Rajasekhar-Ilaparti/Seed-Dispensing-Rover-ESP32-C3/(commit log)

2026-11-05 Seed Dispensing Rover: ESP32-C3 firmware, wiring and docs
    Wi-Fi controlled seed-sowing rover on an ESP32-C3 Super Mini with a
    DRV8833 driver, MPU6050 gyro and servo seed hopper. The rover hosts its
    own controller page (joystick, dispense once/continuous, servo, square
    path and gyro calibration, diagnostics) and supports OTA updates.
2026-11-06 Drive tab dispense options follow saved Dispenser settings
    The Drive tab loaded swing speed and cycles from values remembered on
    the phone, so settings saved on the Dispenser tab were ignored. They now
    come from the rover's saved servo settings, update as soon as Save is
    pressed, and a running continuous dispense picks them up. The interval
    is still remembered on the phone.
2026-11-06 Lock hopper servo angles; Dispenser tab tunes timing only
    The open/closed angles are now constants in the firmware (135/75) and
    can't be changed from the controller: the live-angle control and
    /servo/set are removed, and /servo/save and /servo/test only accept
    swing speed, hold time and swings. The Dispenser tab shows the locked
    angles read-only with a caution box, and Save asks for confirmation.
2026-11-09 Fix weak low-speed driving: kick-start and full-range speed slider
    At low speed settings the joystick drove both sides at PWM 70, which
    spins the wheels in the air but barely moves a 4-wheel skid-steer rover
    on the ground, and the bottom of the speed slider all mapped to that
    same value. Each side now gets a 150 ms kick at PWM 150 when it starts
    from standstill, the minimum drive PWM is 90, and the slider spans
    PWM 90 (20 %) to 200 (100 %).
    [C3_Seed_Rover.ino]
2026-11-09 Adjustable drive power: minimum PWM and start kick
    PWM 90 was still too weak on the floor at low speed. The minimum drive
    power and the start kick are now settings on the Calibration tab
    (defaults 110 / 170), applied immediately and saved in NVS, so they can
    be tuned to the surface without a firmware upload. Also stops field
    labels from overflowing narrow phone screens.
    [C3_Seed_Rover.ino]
2026-11-09 Soft-start the motors instead of a start kick
    A sudden PWM step into stalled motors (the jump to minimum power plus
    the start kick) tripped the DRV8833 over-current protection, so the
    motors hummed on the ground while the slow ramp in the motor diagnostic
    started them fine. A side leaving standstill now begins at PWM 60 and
    speeds up at 300 PWM/s; stopping and reversing are unchanged. The start
    kick setting is removed (and its saved value erased); minimum drive
    power stays adjustable.
    [C3_Seed_Rover.ino]
2026-11-09 Switch to the TC1508A motor driver
    - Map motor sides for the TC1508A wiring (SIDES_SWAPPED, RIGHT_REVERSED,
    JOY_SWAP_LR) and document the flags for the original DRV8833 wiring
    - Fix drive power in firmware at PWM 50-100 (keeps the TC1508A cool),
    soft start from PWM 40; remove the Drive power calibration card
    - Clear old drive-power settings from NVS on boot
    - Update wiring, README, calibration and troubleshooting docs, including
    the TC1508A's 7.2 V rating against a 2S pack
    [C3_Seed_Rover.ino]
2026-11-09 Reverse the left motors in software after re-soldering
    Adds LEFT_REVERSED (true for the current TC1508A wiring) and documents it
    alongside SIDES_SWAPPED, RIGHT_REVERSED and JOY_SWAP_LR.
    [C3_Seed_Rover.ino]
